frankschoeniger/LIN_Interface/Pictures/IMG_0122-1.jpg

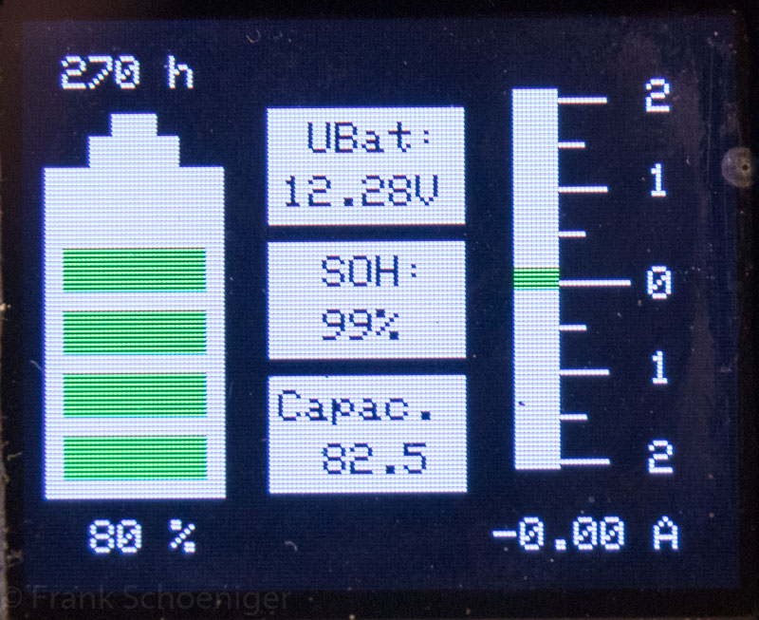
Pictures/IMG_0122-1.jpg
