frankschoeniger/LIN_Interface/Pictures/IMG_0124-1.jpg

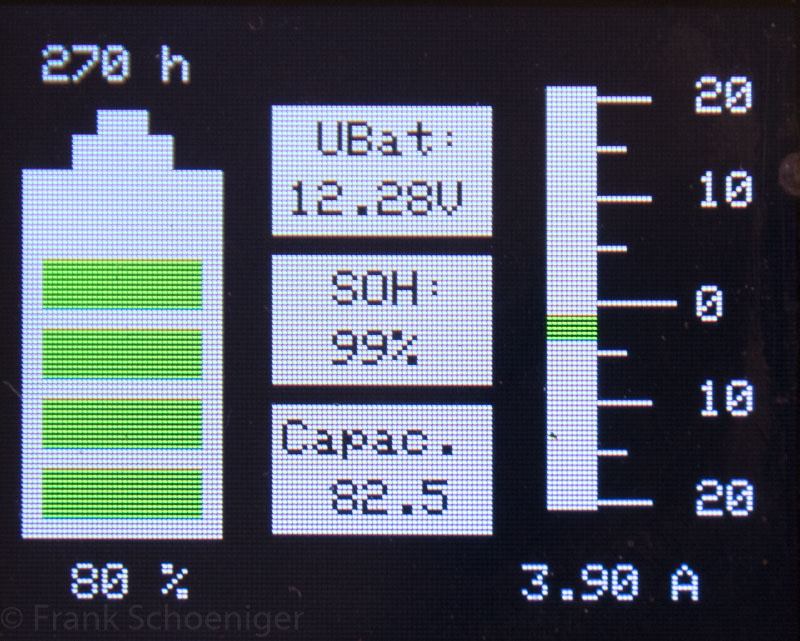
Pictures/IMG_0124-1.jpg
