frankschoeniger/LIN_Interface/Pictures/IMG_0123-1.jpg

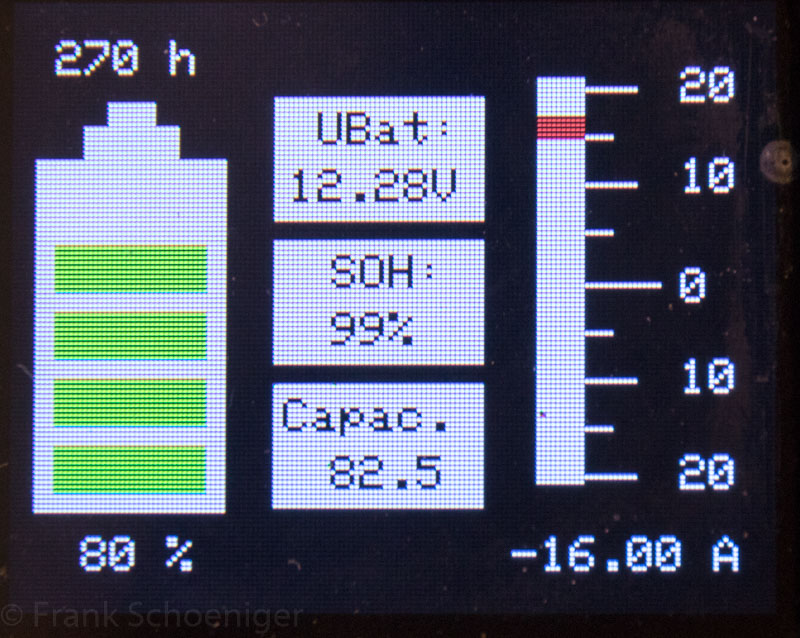
Pictures/IMG_0123-1.jpg
