frankschoeniger/LIN_Interface/Pictures/IMG_0127-1.jpg

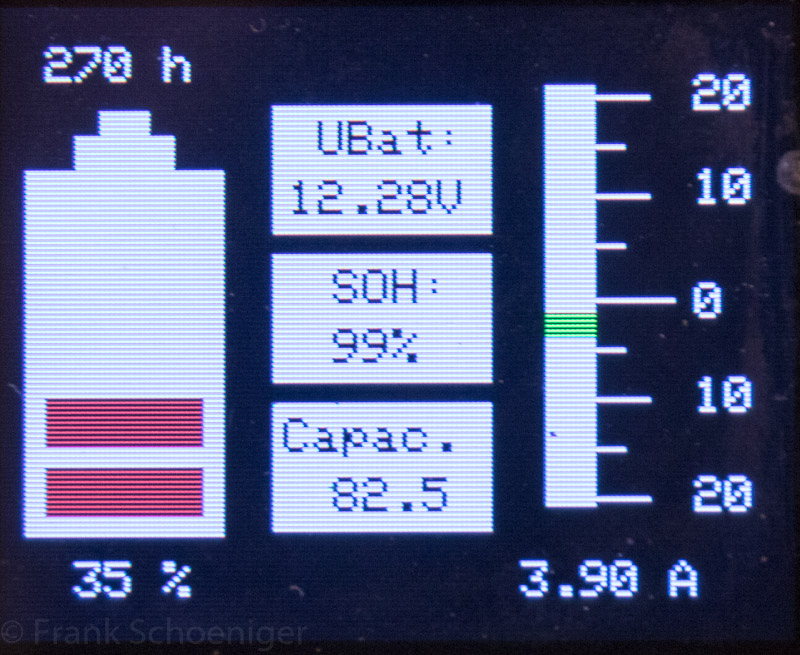
Pictures/IMG_0127-1.jpg
