frankschoeniger/LIN_Interface/Pictures/IMG_0128-1.jpg

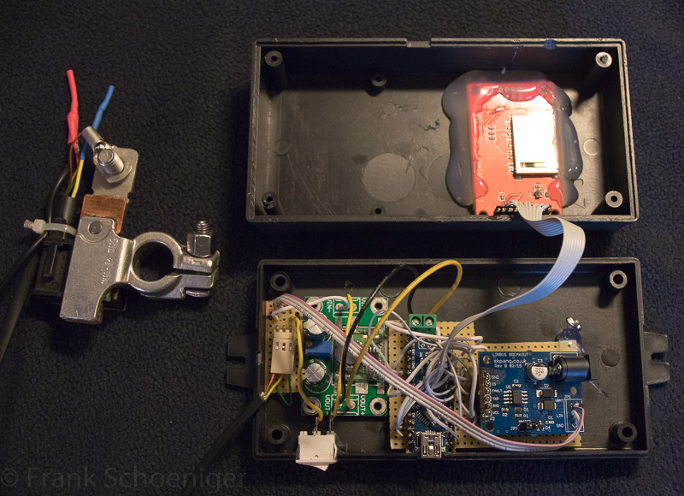
Pictures/IMG_0128-1.jpg
