frankschoeniger/LIN_Interface/Pictures/IMG_0129-1.jpg

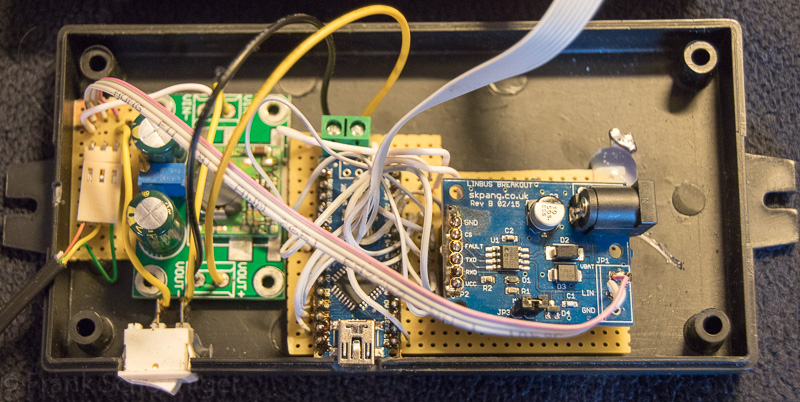
Pictures/IMG_0129-1.jpg
