frankschoeniger/LIN_Interface/(commit log)

2017-01-10 next alpha version with LCD Display
    changed initialization of the Lin Message Array
    corrected some errors
    all messages will be correct read except frame 5
    [Battmonitor.ino]
2017-01-13 new alpha - looks like it works
    changed timing
    switch UART off at the time reading LIN Bus
2017-03-26 Update Battmonitor.ino
    Time calculation for break sequenze is wrong. delay() expects the unit milliseconds.
    [Battmonitor.ino]
